GroanKing05/Quadrature-Down-Converter/README.md

## Quadrature-Down-Converter

Circuit made for Analog Electronic Circuits course, Spring 2024 @ IIIT-H
