GroanKing05/Quadrature-Down-Converter/Oscilloscope Images/scope_7.png

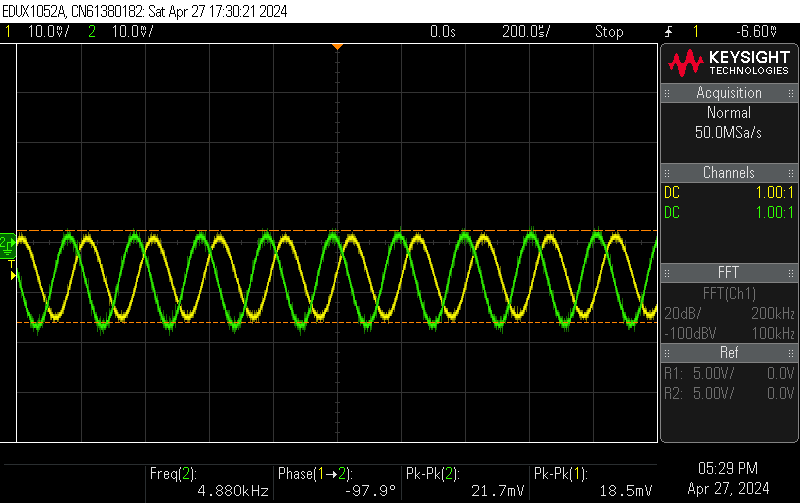
Oscilloscope Images/scope_7.png
