GroanKing05/Quadrature-Down-Converter/Oscilloscope Images/scope_9.png

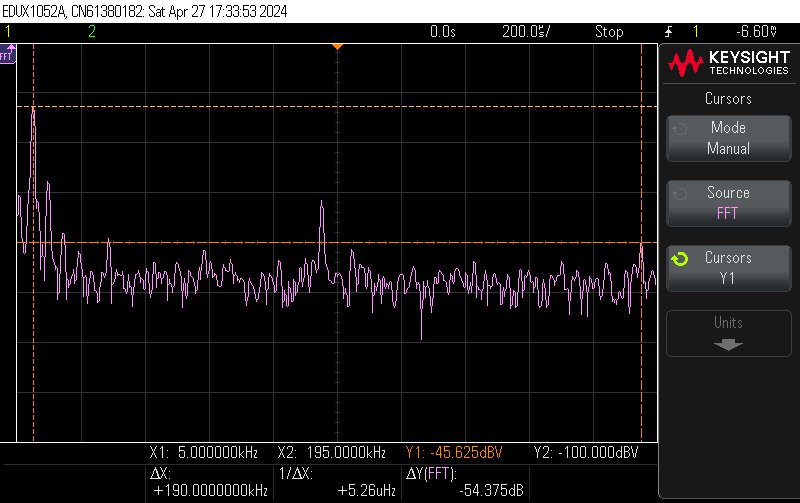
Oscilloscope Images/scope_9.png
