GroanKing05/Quadrature-Down-Converter/Oscilloscope Images/scope_10.png

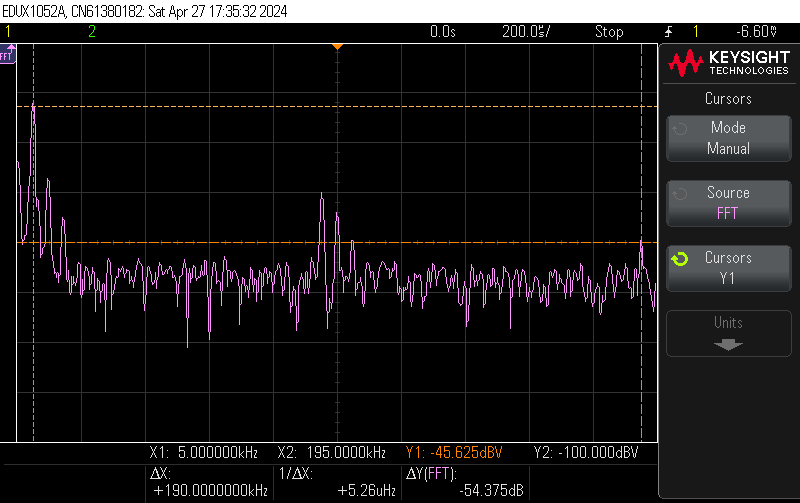
Oscilloscope Images/scope_10.png
