GroanKing05/Quadrature-Down-Converter/Oscilloscope Images/scope_11.png

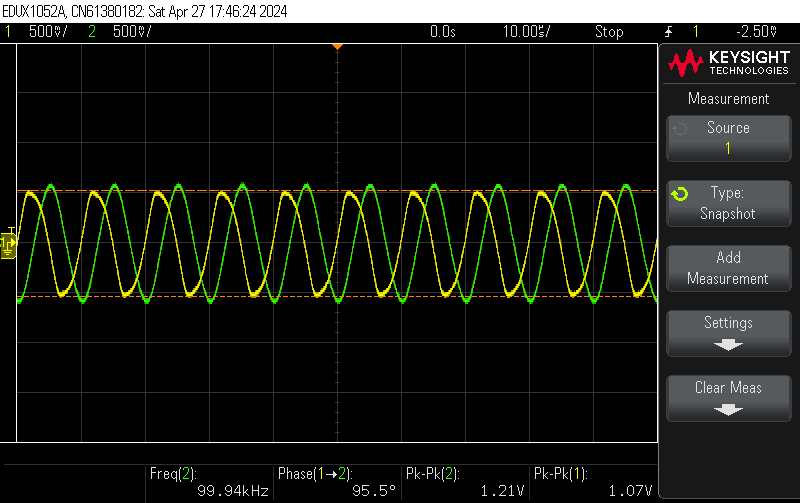
Oscilloscope Images/scope_11.png
