GroanKing05/Quadrature-Down-Converter/Oscilloscope Images/scope_12.png

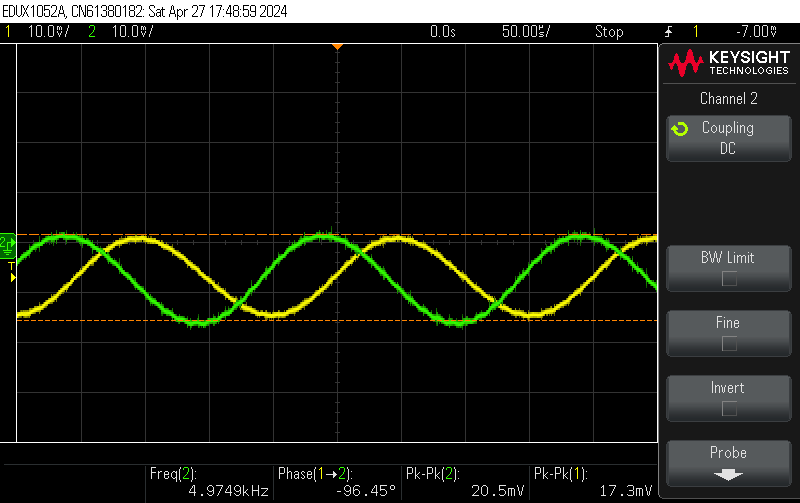
Oscilloscope Images/scope_12.png
