GroanKing05/Quadrature-Down-Converter/Oscilloscope Images/scope_15.png

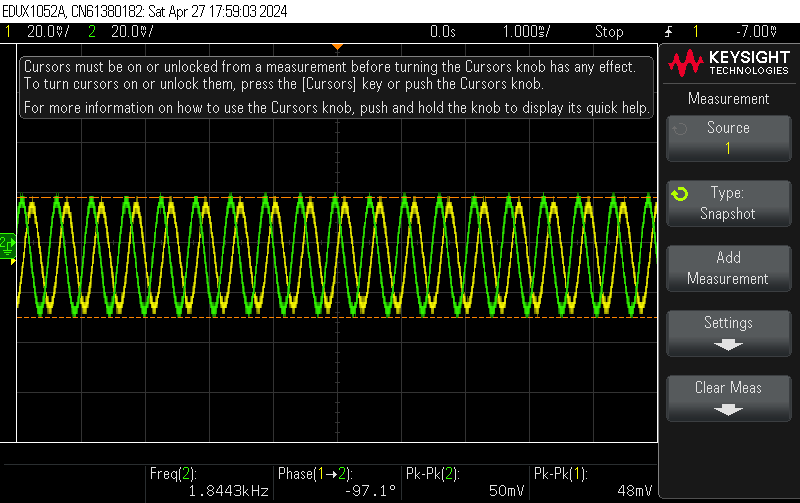
Oscilloscope Images/scope_15.png
