GroanKing05/Quadrature-Down-Converter/Oscilloscope Images/scope_16.png

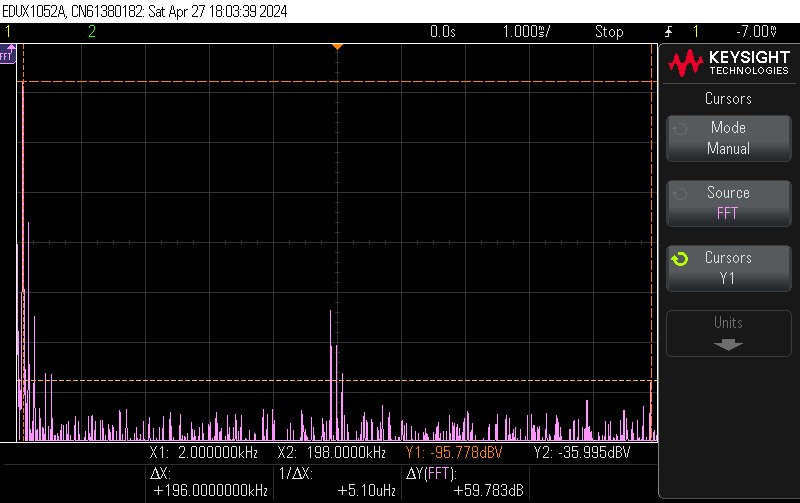
Oscilloscope Images/scope_16.png
