GroanKing05/Quadrature-Down-Converter/Oscilloscope Images/scope_18.png

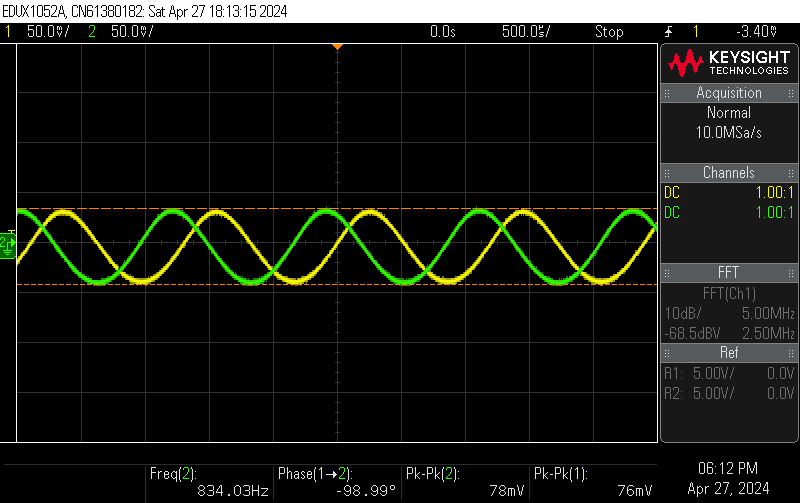
Oscilloscope Images/scope_18.png
