GroanKing05/Quadrature-Down-Converter/Oscilloscope Images/scope_21.png

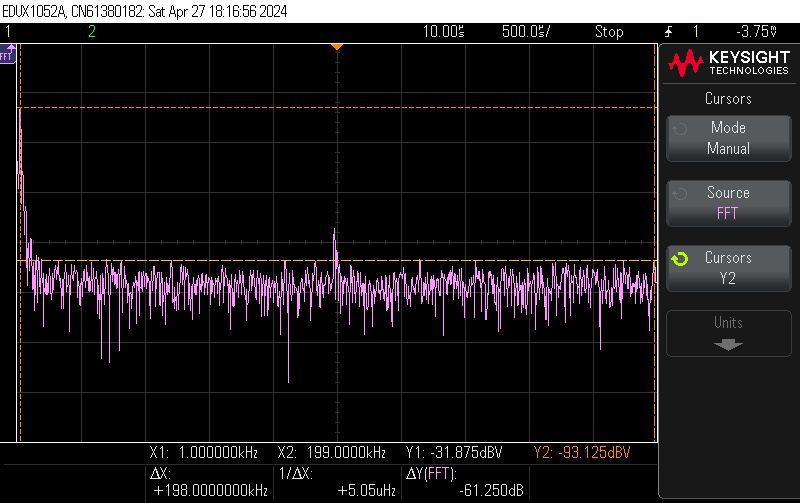
Oscilloscope Images/scope_21.png
