GroanKing05/Quadrature-Down-Converter/Oscilloscope Images/scope_22.png

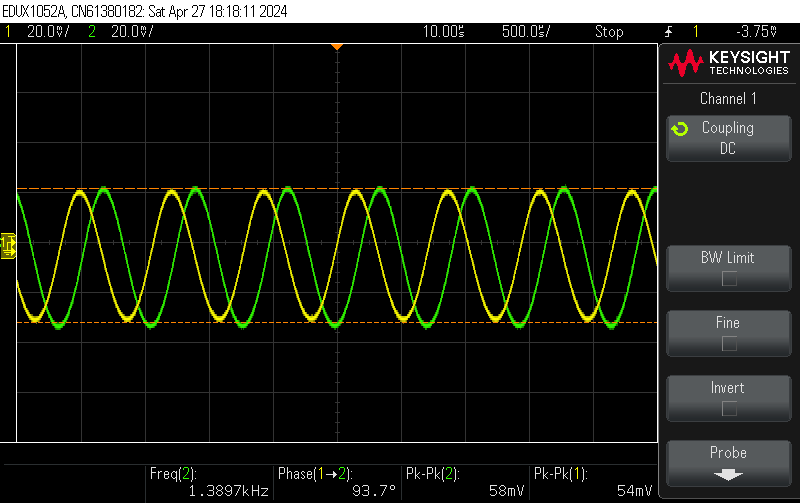
Oscilloscope Images/scope_22.png
