GroanKing05/Quadrature-Down-Converter/Oscilloscope Images/scope_23.png

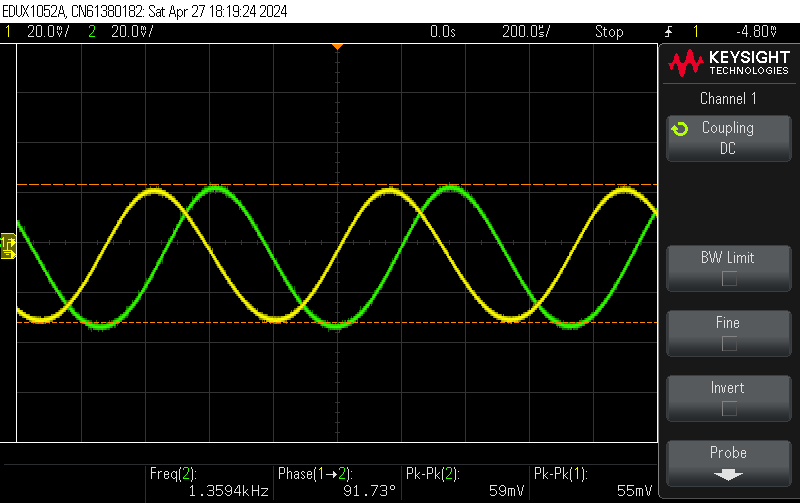
Oscilloscope Images/scope_23.png
