GroanKing05/Quadrature-Down-Converter/Oscilloscope Images/scope_24.png

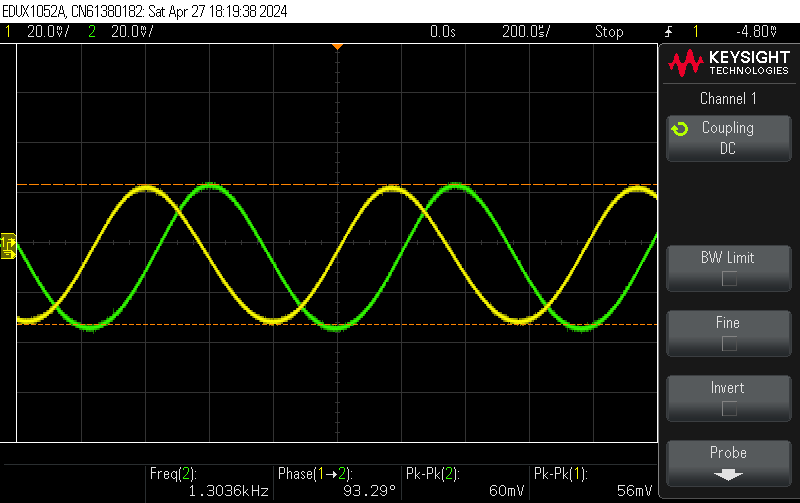
Oscilloscope Images/scope_24.png
