GroanKing05/Quadrature-Down-Converter/Oscilloscope Images/scope_26.png

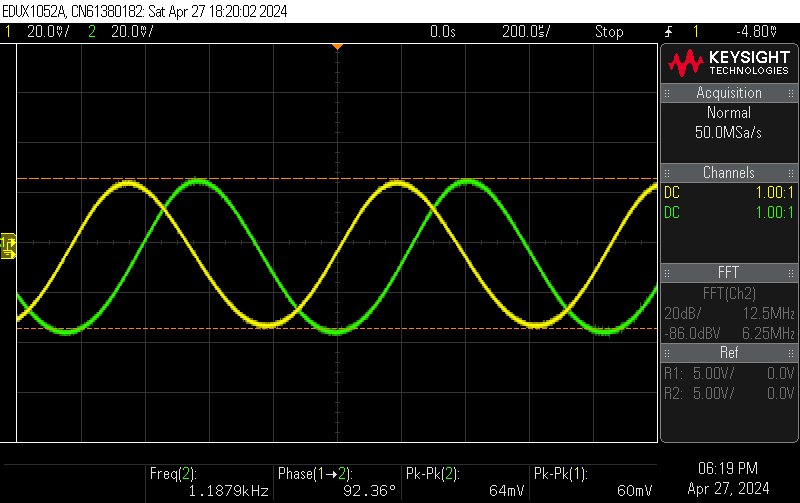
Oscilloscope Images/scope_26.png
