GroanKing05/Quadrature-Down-Converter/Oscilloscope Images/scope_29.png

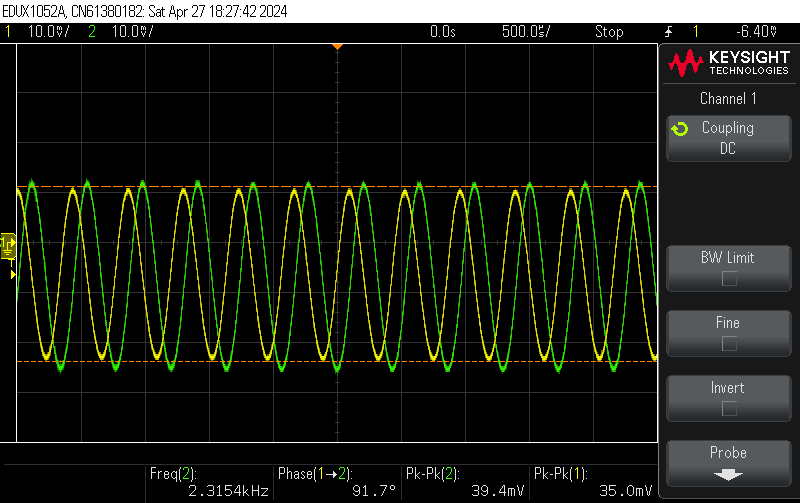
Oscilloscope Images/scope_29.png
