GroanKing05/Quadrature-Down-Converter/Oscilloscope Images/scope_30.png

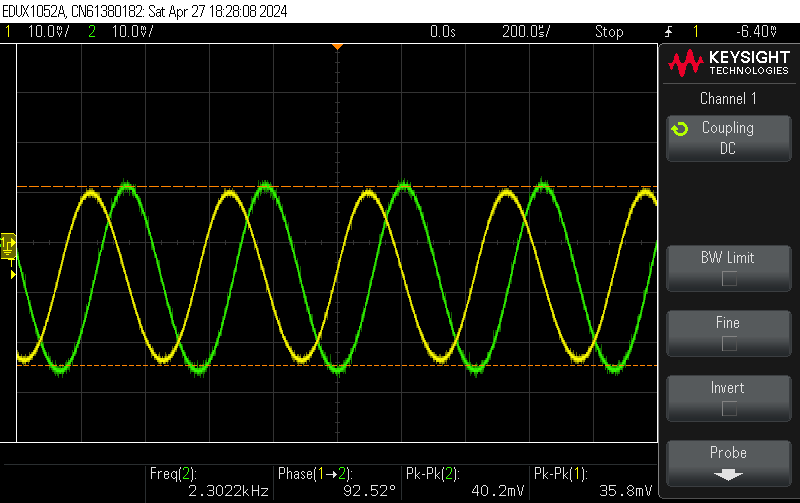
Oscilloscope Images/scope_30.png
