GroanKing05/Quadrature-Down-Converter/Oscilloscope Images/scope_32.png

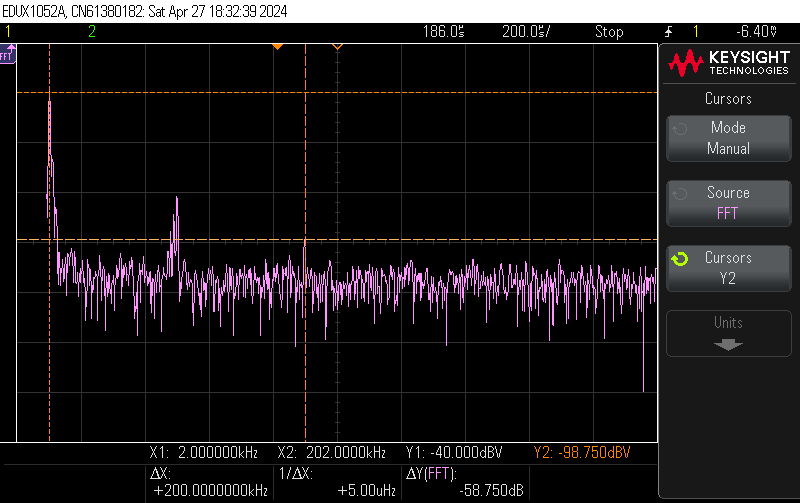
Oscilloscope Images/scope_32.png
