GroanKing05/Quadrature-Down-Converter/Oscilloscope Images/scope_33.png

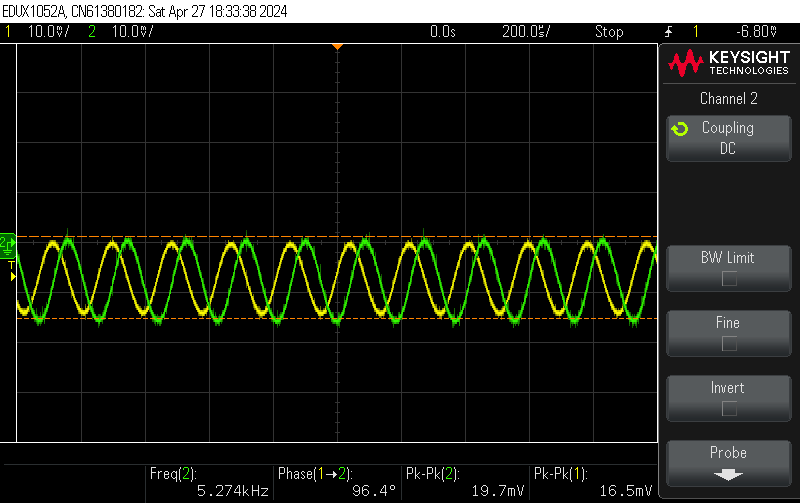
Oscilloscope Images/scope_33.png
