GroanKing05/Quadrature-Down-Converter/Oscilloscope Images/scope_34.png

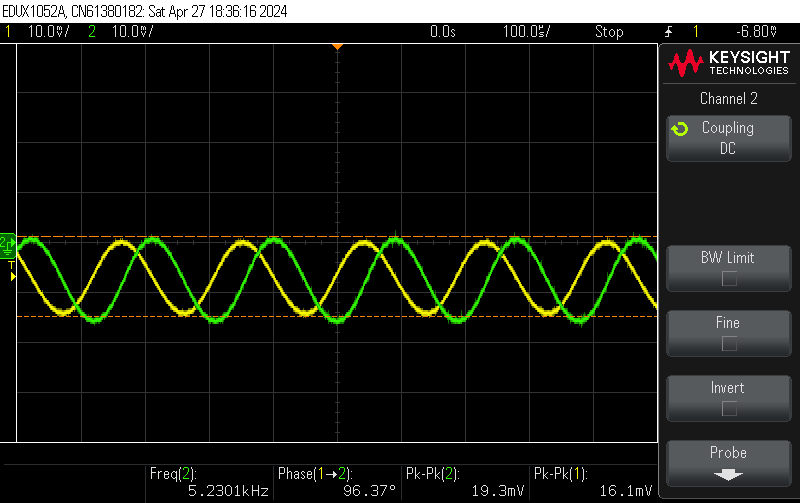
Oscilloscope Images/scope_34.png
