GroanKing05/Quadrature-Down-Converter/Oscilloscope Images/scope_36.png

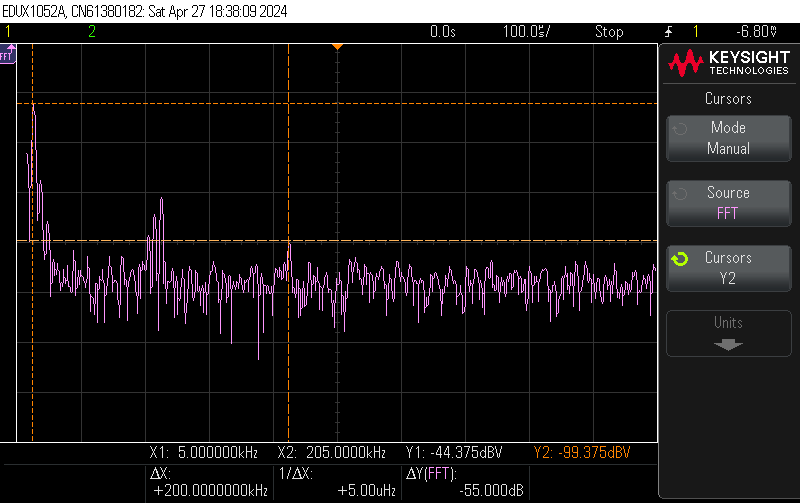
Oscilloscope Images/scope_36.png
