GroanKing05/Quadrature-Down-Converter/Oscilloscope Images/scope_37.png

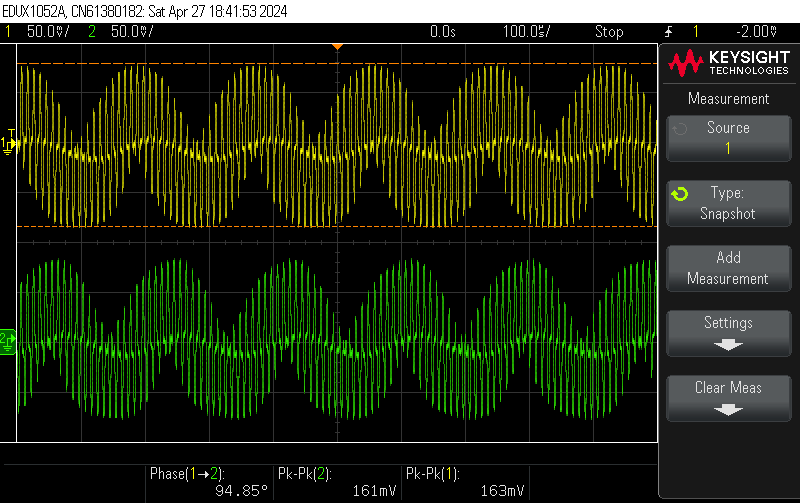
Oscilloscope Images/scope_37.png
