GroanKing05/Quadrature-Down-Converter/Oscilloscope Images/scope_38.png

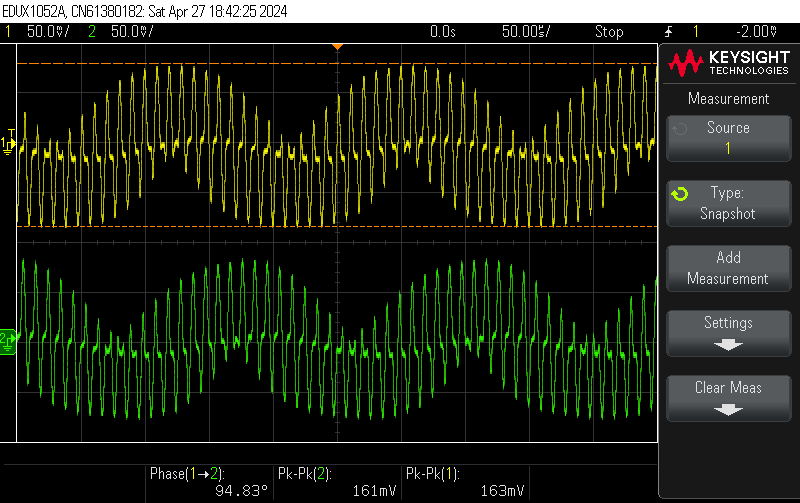
Oscilloscope Images/scope_38.png
