GroanKing05/Quadrature-Down-Converter/Oscilloscope Images/scope_40.png

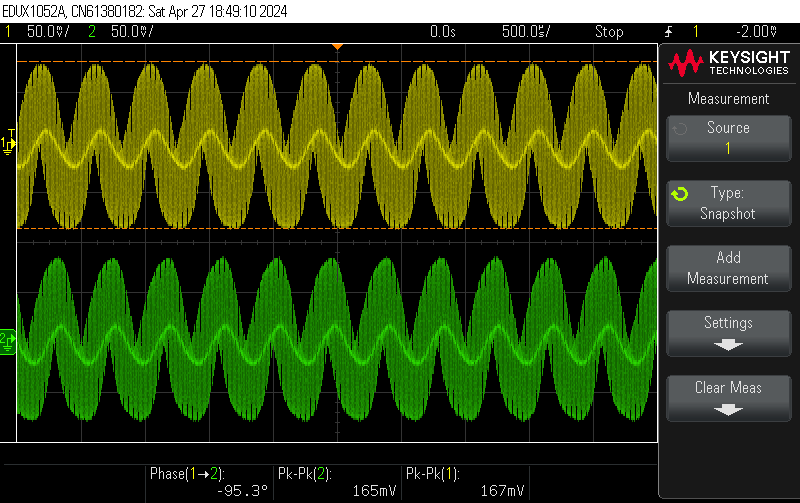
Oscilloscope Images/scope_40.png
