GroanKing05/Quadrature-Down-Converter/Oscilloscope Images/scope_41.png

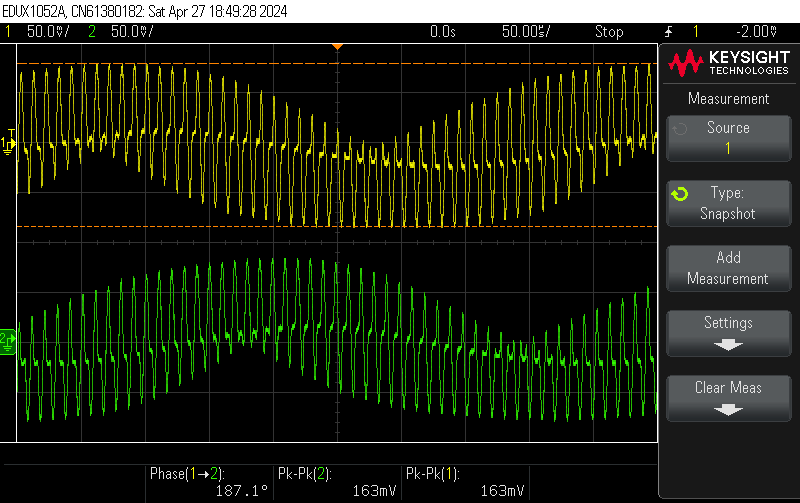
Oscilloscope Images/scope_41.png
