GroanKing05/Quadrature-Down-Converter/Oscilloscope Images/scope_43.png

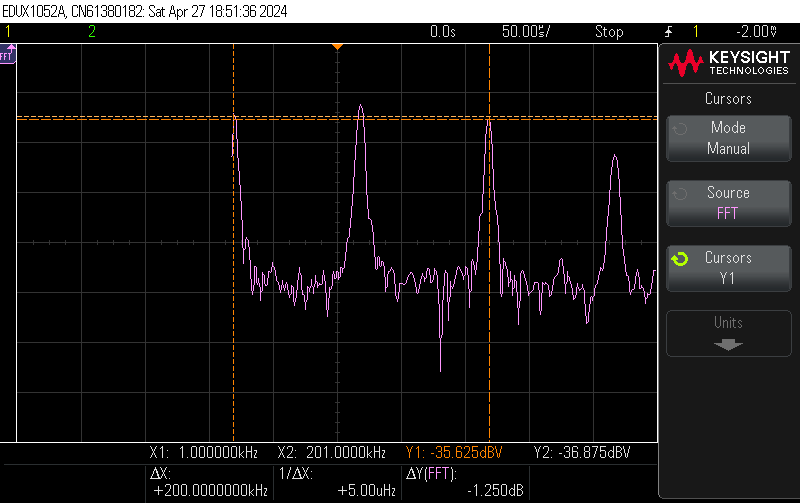
Oscilloscope Images/scope_43.png
