GroanKing05/Quadrature-Down-Converter/Oscilloscope Images/scope_44.png

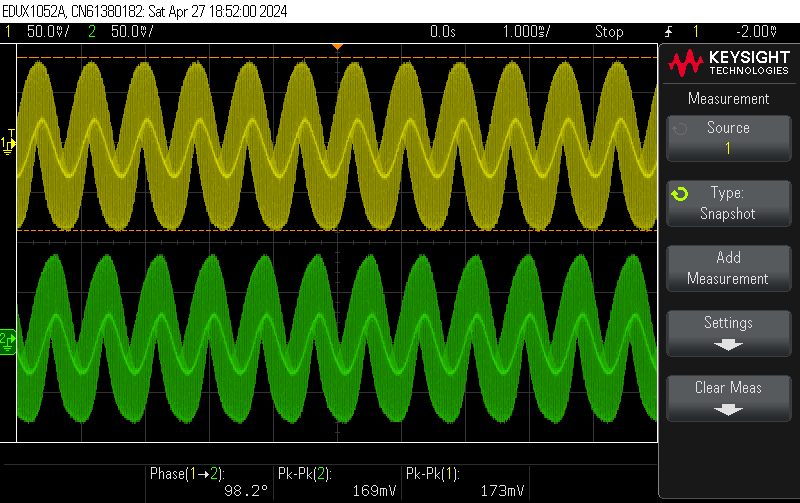
Oscilloscope Images/scope_44.png
