GroanKing05/Quadrature-Down-Converter/Oscilloscope Images/scope_45.png

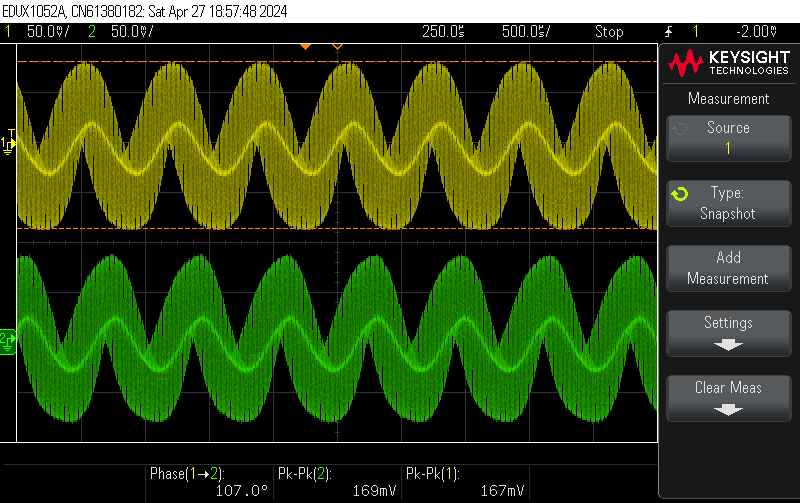
Oscilloscope Images/scope_45.png
