GroanKing05/Quadrature-Down-Converter/Oscilloscope Images/scope_46.png

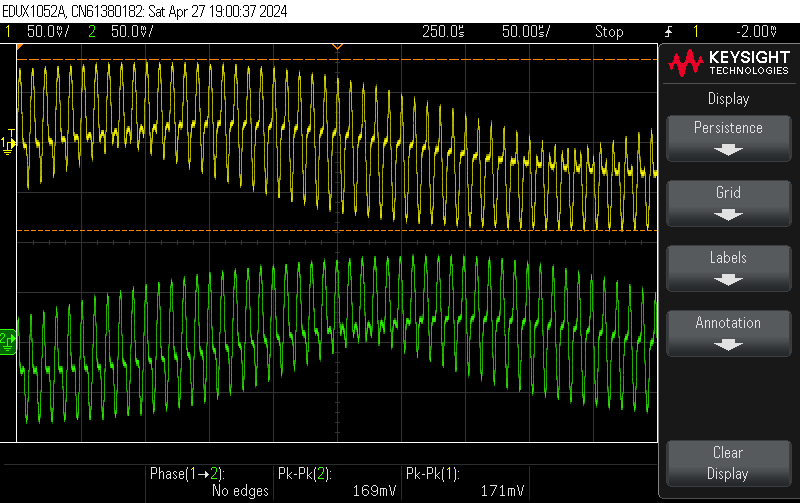
Oscilloscope Images/scope_46.png
