GroanKing05/Quadrature-Down-Converter/Oscilloscope Images/scope_48.png

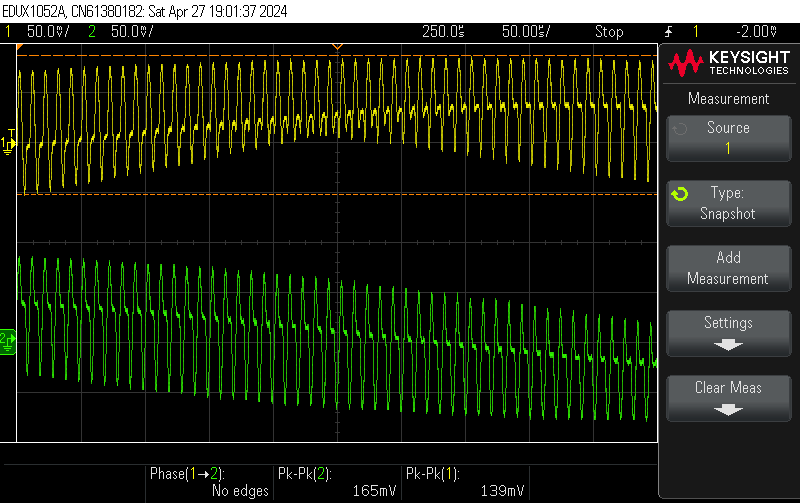
Oscilloscope Images/scope_48.png
