GroanKing05/Quadrature-Down-Converter/Oscilloscope Images/scope_50.png

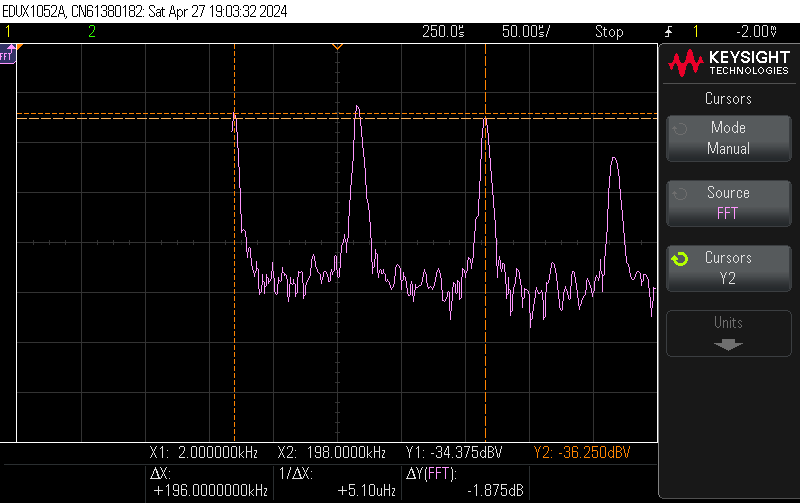
Oscilloscope Images/scope_50.png
