GroanKing05/Quadrature-Down-Converter/Oscilloscope Images/scope_51.png

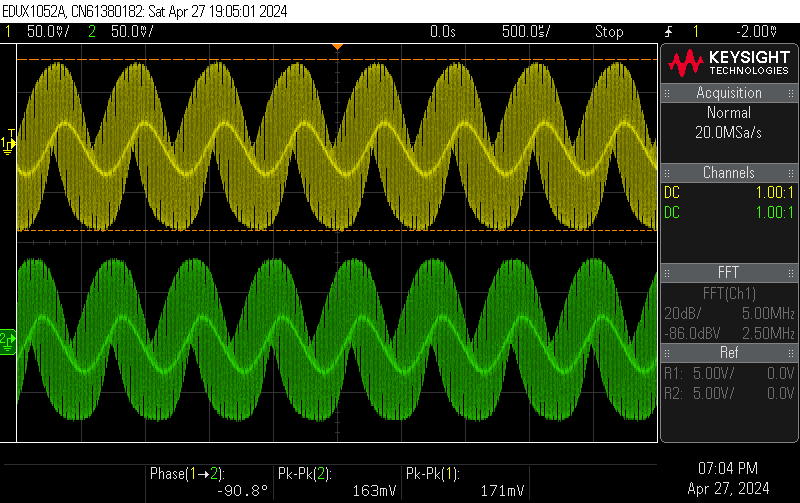
Oscilloscope Images/scope_51.png
