GroanKing05/Quadrature-Down-Converter/Oscilloscope Images/scope_52.png

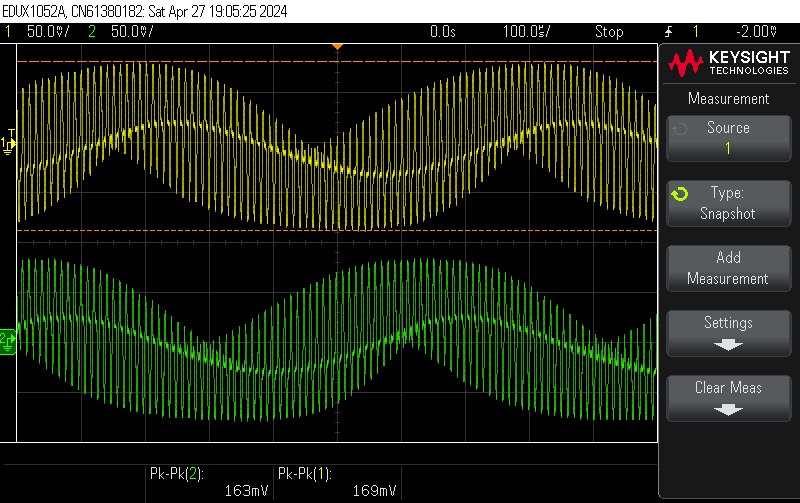
Oscilloscope Images/scope_52.png
