GroanKing05/Quadrature-Down-Converter/Oscilloscope Images/scope_53.png

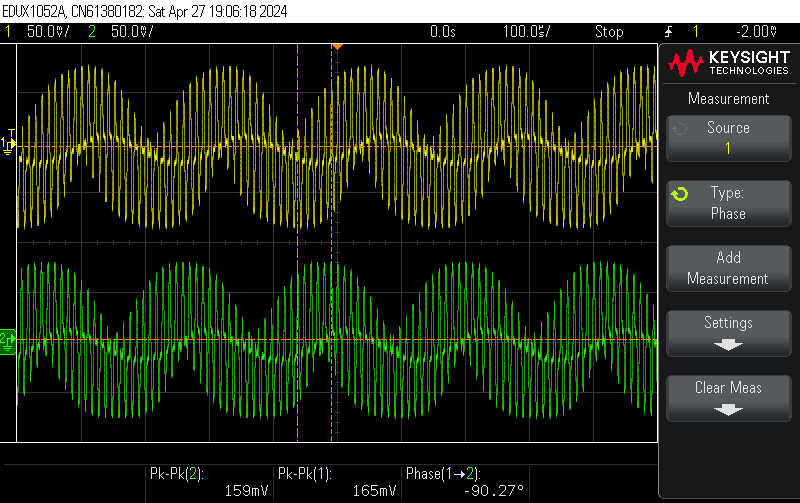
Oscilloscope Images/scope_53.png
