GroanKing05/Quadrature-Down-Converter/Oscilloscope Images/scope_54.png

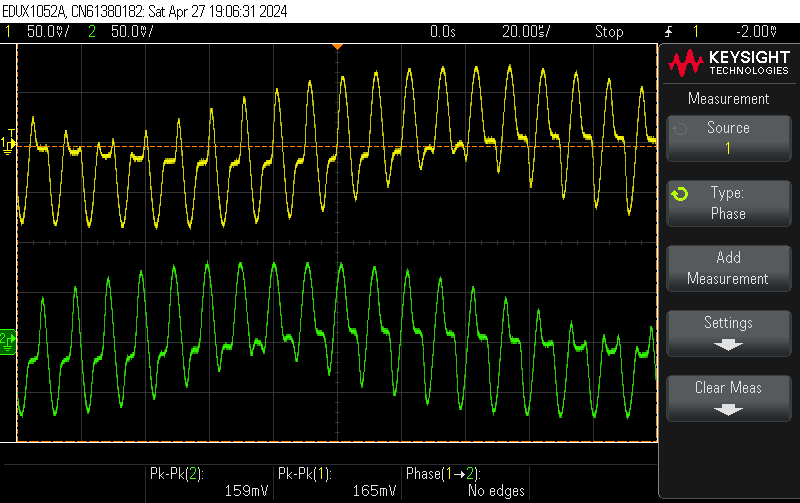
Oscilloscope Images/scope_54.png
