GroanKing05/Quadrature-Down-Converter/Oscilloscope Images/scope_55.png

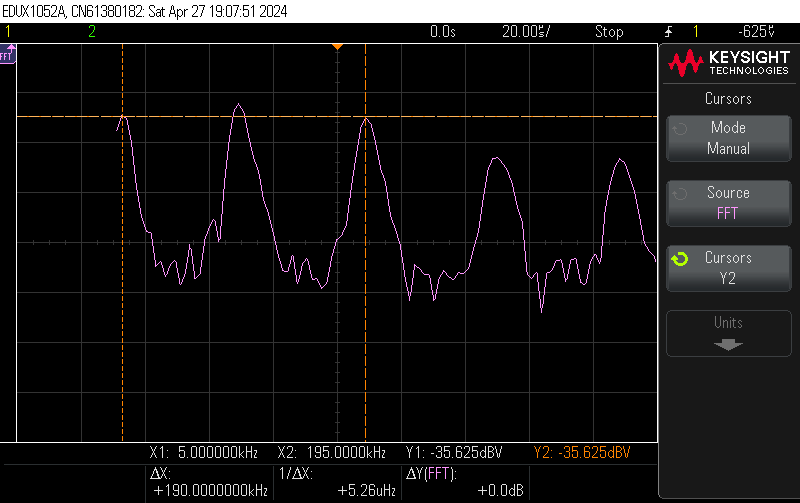
Oscilloscope Images/scope_55.png
