GroanKing05/Quadrature-Down-Converter/Oscilloscope Images/scope_56.png

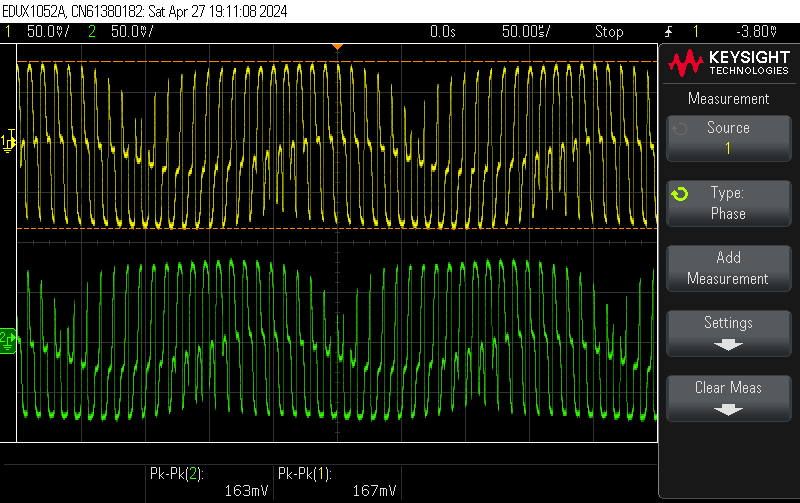
Oscilloscope Images/scope_56.png
