GroanKing05/Quadrature-Down-Converter/Oscilloscope Images/scope_57.png

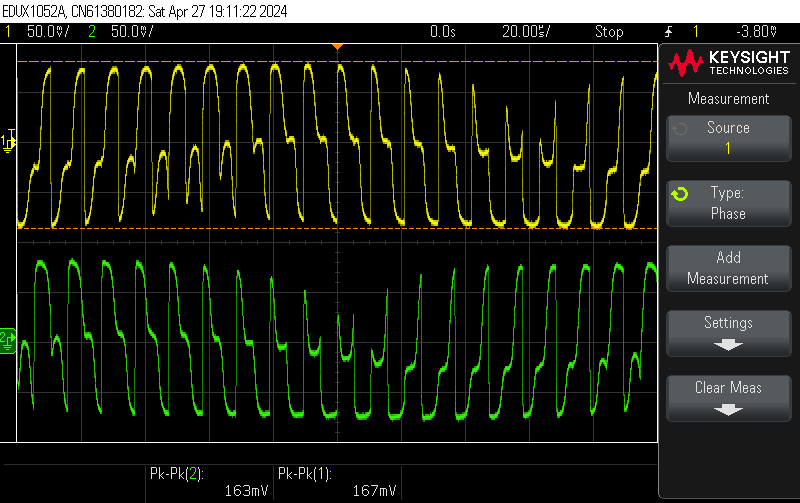
Oscilloscope Images/scope_57.png
