GroanKing05/Quadrature-Down-Converter/Oscilloscope Images/scope_58.png

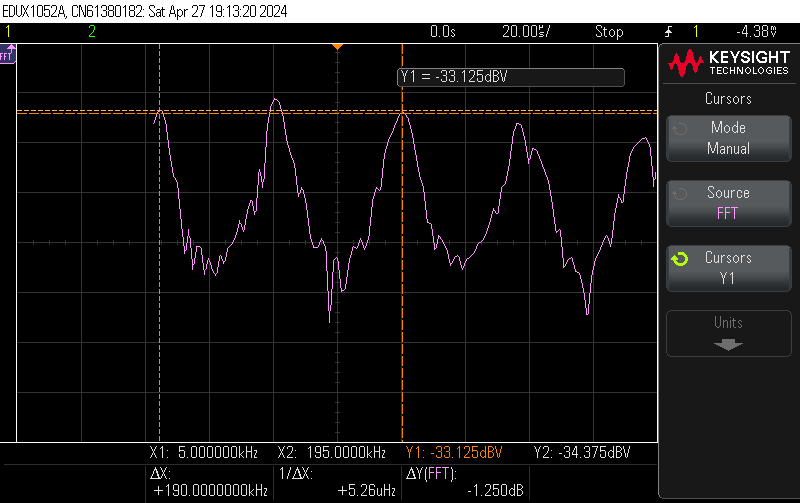
Oscilloscope Images/scope_58.png
