GroanKing05/Quadrature-Down-Converter/Oscilloscope Images/scope_59.png

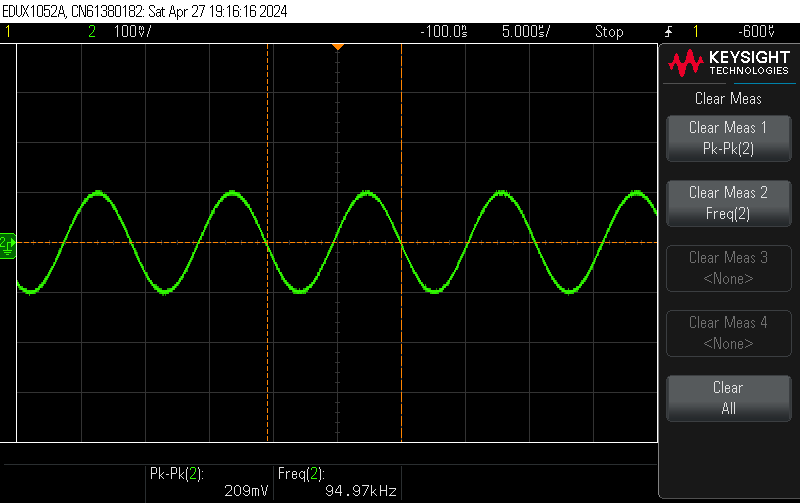
Oscilloscope Images/scope_59.png
