GroanKing05/Quadrature-Down-Converter/Oscilloscope Images/scope_60.png

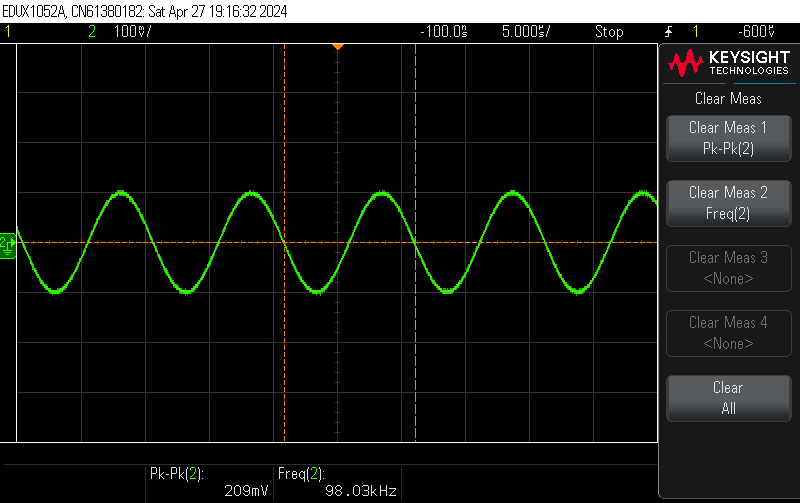
Oscilloscope Images/scope_60.png
