GroanKing05/Quadrature-Down-Converter/Oscilloscope Images/scope_61.png

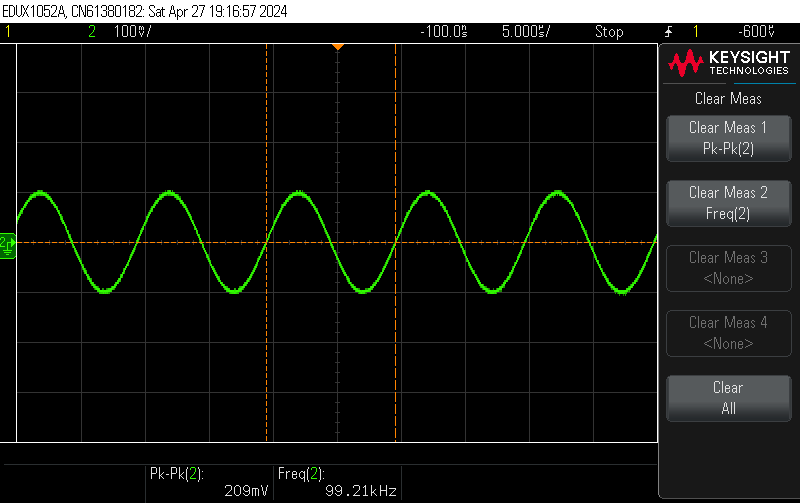
Oscilloscope Images/scope_61.png
