GroanKing05/Quadrature-Down-Converter/Oscilloscope Images/scope_64.png

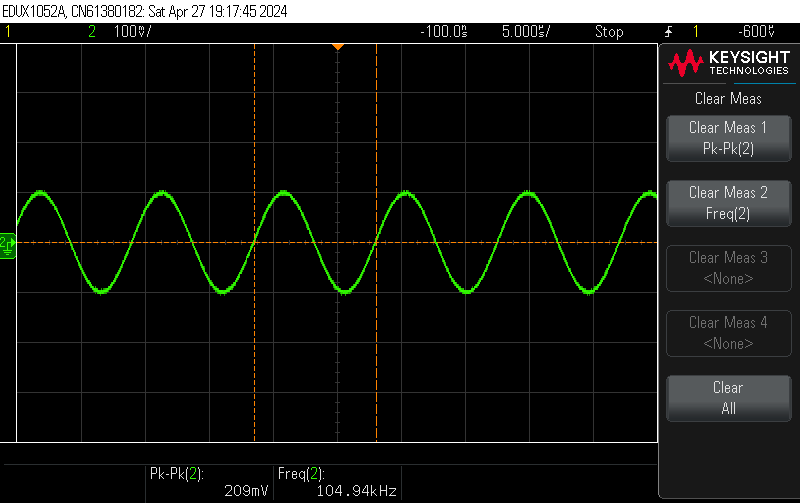
Oscilloscope Images/scope_64.png
