GroanKing05/Quadrature-Down-Converter/LTSpices/Circuit1.asc

C1: cap; 0.7n
C2: cap; 0.7n
C5: cap; 1µ
C6: cap; 1µ
C7: cap; 10n
C8: cap; 10n
C9: cap; 10n
C10: cap; 10n
Cc1: cap; 100p
Cc2: cap; 100p
D1: diode; 1N4148
D2: diode; 1N4148
M1: nmos4; CMOSN; l={2*LAMBDA} w={widthN} ad={5*widthN*LAMBDA} as={5*widthN*LAMBDA} pd={10*LAMBDA + 2*widthN} ps={10*LAMBDA + 2*widthN}
M3: nmos4; CMOSN; l={2*LAMBDA} w={widthN} ad={5*widthN*LAMBDA} as={5*widthN*LAMBDA} pd={10*LAMBDA + 2*widthN} ps={10*LAMBDA + 2*widthN}
R1: res; {R}
R2: res; 50
R3: res; 1Meg
R4: res; 50
R5: res; 1Meg
R6: res; {2*R}
R7: res; {2*R}
R8: res; {2*R}
R9: res; {2*R}
R12: res; 1k
R13: res; 1k
R14: res; 2.974k
R15: res; 2.974k
R16: res; 2.974k
R17: res; 2.974k
Rbias1: res; 100k
Rbias2: res; 100k
U1: opamp2; UA741
U2: opamp2; UA741
V1: voltage; 8
V2: voltage; 8
Vbias1: voltage; 1
Vbias2: voltage; 1
Vin1: voltage; SINE(0 100m 101k)
Vin2: voltage; SINE(0 100m 101k)
Named nets: 0, cos, sine, Vif, Viq, SINEout, COSINEout
.inc "C:\\Users\\varun\\OneDrive\\Documents\\Sem2\\AEC\\Project\\TSMC_180nm.txt"
.inc "C:\\Users\\varun\\OneDrive\\Documents\\Sem2\\AEC\\Project\\UA741.301"
.param LAMBDA=0.09u
.param widthN = 1.8u
.tran 10m
.param R = 1.77k
