GroanKing05/Quadrature-Down-Converter/LTSpices/Circuit3.asc

C1: cap; 77.08p
C2: cap; 77.08p
C3: cap; 10n
C4: cap; 10n
C5: cap; 10n
C6: cap; 10n
Cc1: cap; 100p
Cc2: cap; 100p
D1: diode; 1N4148
D2: diode; 1N4148
M1: nmos4; CMOSN; l={2*LAMBDA} w={width_N} ad={5*width_N*LAMBDA} as={5*width_N*LAMBDA} pd={10*LAMBDA + 2*width_N} ps={10*LAMBDA + 2*width_N} m=1
M2: nmos4; CMOSN; l={2*LAMBDA} w={width_N} ad={5*width_N*LAMBDA} as={5*width_N*LAMBDA} pd={10*LAMBDA + 2*width_N} ps={10*LAMBDA + 2*width_N} m=1
R1: res; 15.9k
R2: res; 12.75k
R3: res; 2.7k
R4: res; 2.7k
R5: res; 12.75k
R6: res; 31.8k
R7: res; 31.8k
R8: res; 31.8k
R9: res; 31.8k
R10: res; 8k
R11: res; 8k
R12: res; 8k
R13: res; 8k
RBias1: res; 100k
RBias2: res; 100k
RL1: res; 1k
RL2: res; 1k
U1: opamp2; UA741
U2: opamp2; UA741
U3: opamp2; UA741
V1: voltage; -50m
V2: voltage; -50m
V3: voltage; 8
V4: voltage; 8
Vbias1: voltage; 1
Vbias2: voltage; 1
Vin1: voltage; SINE(0 100m 101k)
Vin2: voltage; SINE(0 100m 101k)
Named nets: 0, out, OUTTT, Vif, VoutCOS, COSPART, Viq, VoutSINE, SINEPART
.inc "C:\\Users\\varun\\OneDrive\\Documents\\Sem2\\AEC\\Project\\UA741.301"
.tran 50m uic
.four 1000 10 -1 V(OUTTT)
.param LAMBDA=0.09u
.param width_N=1.8u
.include "C:\\Users\\varun\\OneDrive\\Documents\\Sem2\\AEC\\Project\\TSMC_180nm.txt"
