GroanKing05/Quadrature-Down-Converter/LTSpices/HPF.asc

C1: cap; 100p
R1: res; 100k
V1: voltage; SINE(); AC 1
Named nets: 0, Vout
.ac dec 1000 1 1G
