GroanKing05/Quadrature-Down-Converter/LTSpices/LPF.asc

C1: cap; 10n
R1: res; 8k
V1: voltage; SINE(); AC 1
Named nets: 0, Vout
.ac dec 1000 1n 1G
