GroanKing05/Quadrature-Down-Converter/LTSpices/Mixer.asc

Cc: cap; 100p
M1: nmos4; CMOSN; l={2*LAMBDA} w={width_N} ad={5*width_N*LAMBDA} as={5*width_N*LAMBDA} pd={10*LAMBDA + 2*width_N} ps={10*LAMBDA + 2*width_N} m=1
RBias: res; 100k
RL: res; 1k
Vbias: voltage; 1
Vin: voltage; SINE(0 100m 105k)
Vosc: voltage; SINE(0 0.5 100k)
Named nets: 0, Vif
.param LAMBDA=0.09u
.param width_N=1.8u
.include "C:\\Users\\varun\\OneDrive\\Documents\\Sem2\\AEC\\Project\\TSMC_180nm.txt"
.tran 5m
