GroanKing05/Quadrature-Down-Converter/LTSpices/V3.asc

C1: cap; {C}
C2: cap; {C}
C3: cap; {C}
C4: cap; {C}
R1: res; {R}
R2: res; {R}
R3: res; {R}
R4: res; {R}
R5: res; {R}
R6: res; {R}
R7: res; {R}
R8: res; {R}
R9: res; {R}
R10: res; {R}
R11: res; {R}
R12: res; {R}
U1: opamp2; UA741
U2: opamp2; UA741
U3: opamp2; UA741
U4: opamp2; UA741
V1: voltage; 12
V2: voltage; 12
Named nets: 0, Vin, cos
.inc "C:\\Users\\varun\\OneDrive\\Documents\\Sem2\\AEC\\Project\\UA741.301"
.param R=1k
.param C = 1.224n
.tran 1m
.ic V(Vin) 50m
